dominikdeka/remote-controlled-ir-tank/shield/docs/photos/vehicle_right.jpg

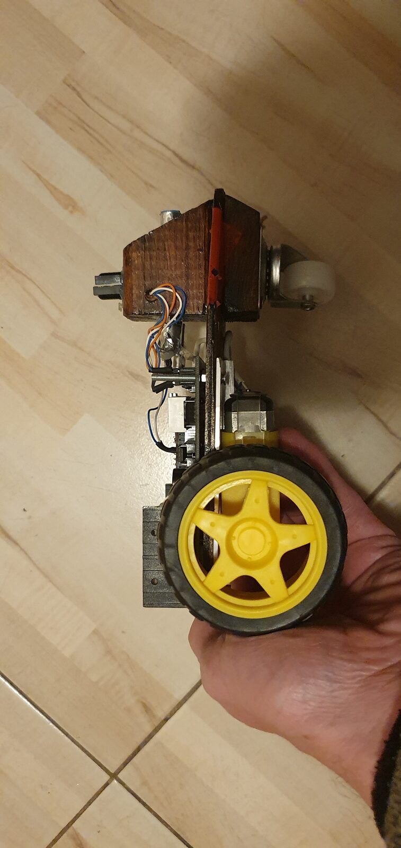
shield/docs/photos/vehicle_right.jpg
