dominikdeka/remote-controlled-ir-tank/shield/docs/photos/controller_front.jpg

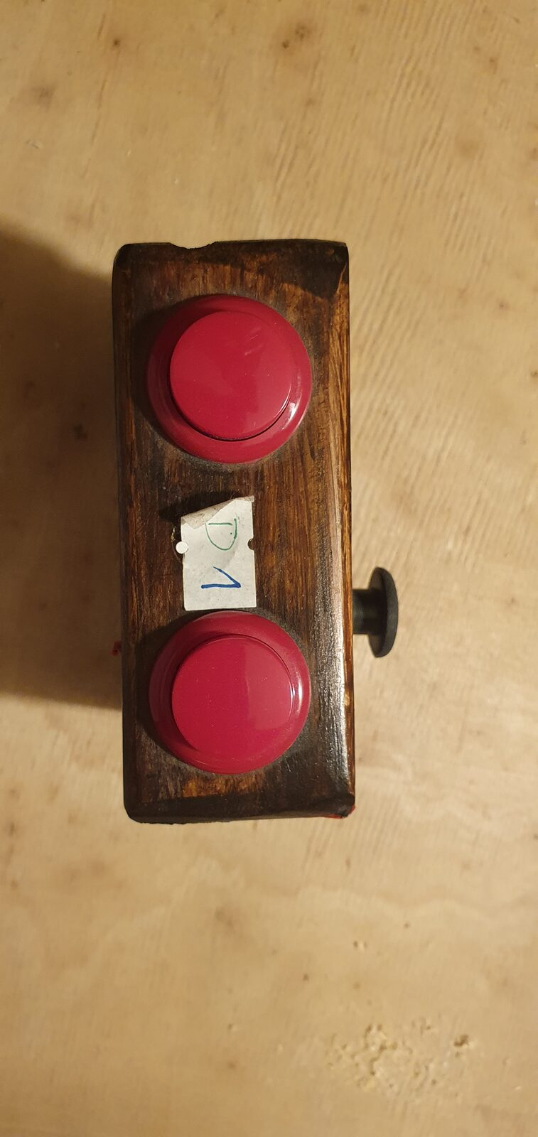
shield/docs/photos/controller_front.jpg
