dominikdeka/remote-controlled-ir-tank/README.md

# remote-controlled-ir-tank
Arduino based remote controlled vehicle with ir gun
