dominikdeka/remote-controlled-ir-tank/shield/docs/photos/controller_side.jpg

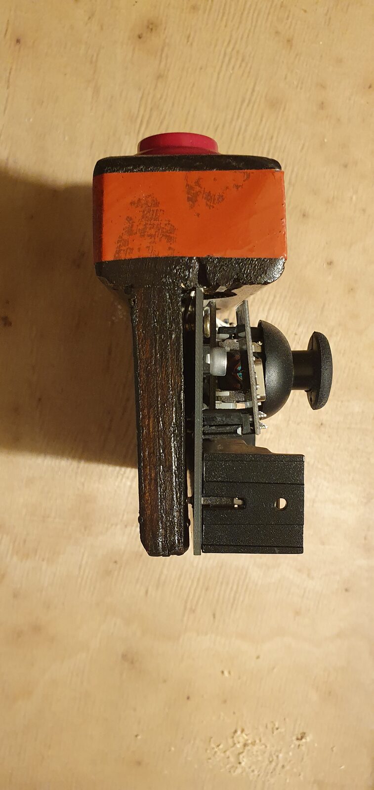
shield/docs/photos/controller_side.jpg
