dominikdeka/remote-controlled-ir-tank/shield/docs/photos/controller_top.jpg

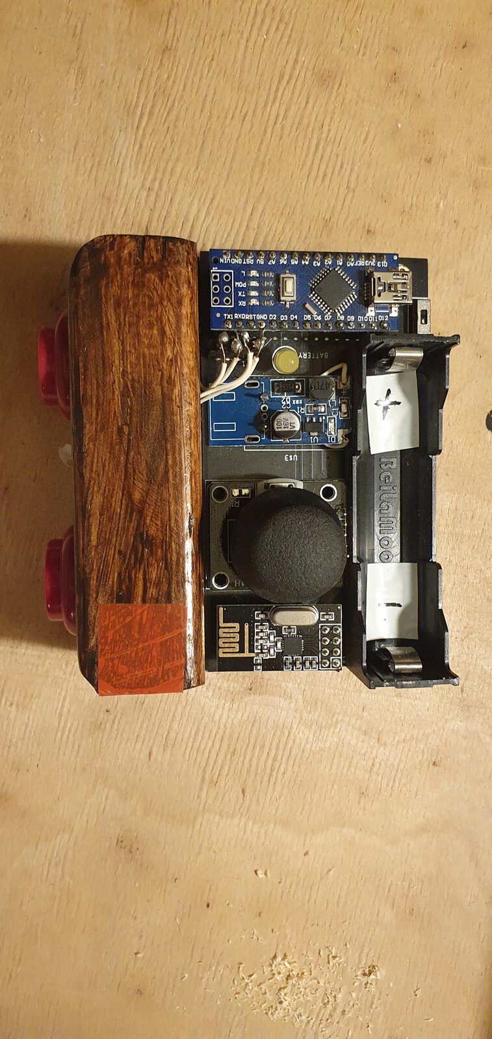
shield/docs/photos/controller_top.jpg
