dominikdeka/remote-controlled-ir-tank/shield/docs/photos/controller_top_tape.jpg

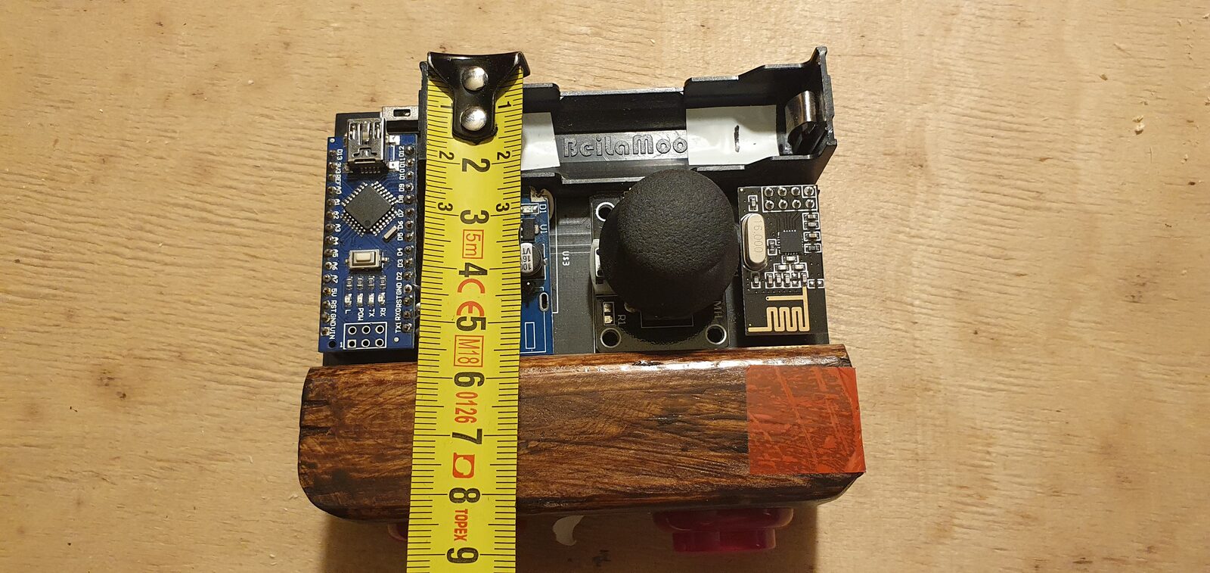
shield/docs/photos/controller_top_tape.jpg
