dominikdeka/remote-controlled-ir-tank/shield/docs/photos/prototype.jpg

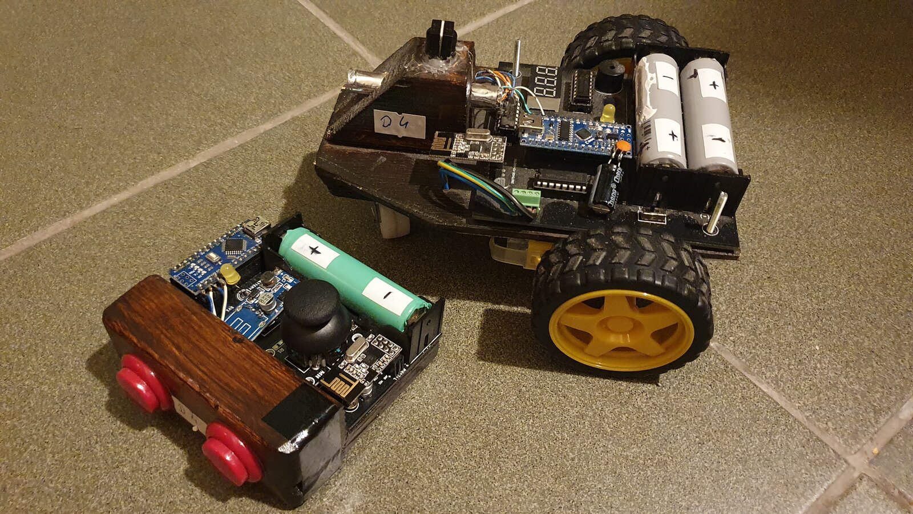
shield/docs/photos/prototype.jpg
