dominikdeka/remote-controlled-ir-tank/shield/docs/photos/tt_motor_drawing.jpg

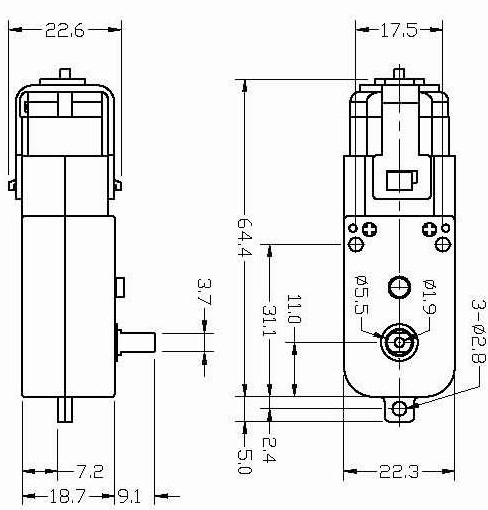
shield/docs/photos/tt_motor_drawing.jpg
