dominikdeka/remote-controlled-ir-tank/shield/docs/photos/vehicle_bottom.jpg

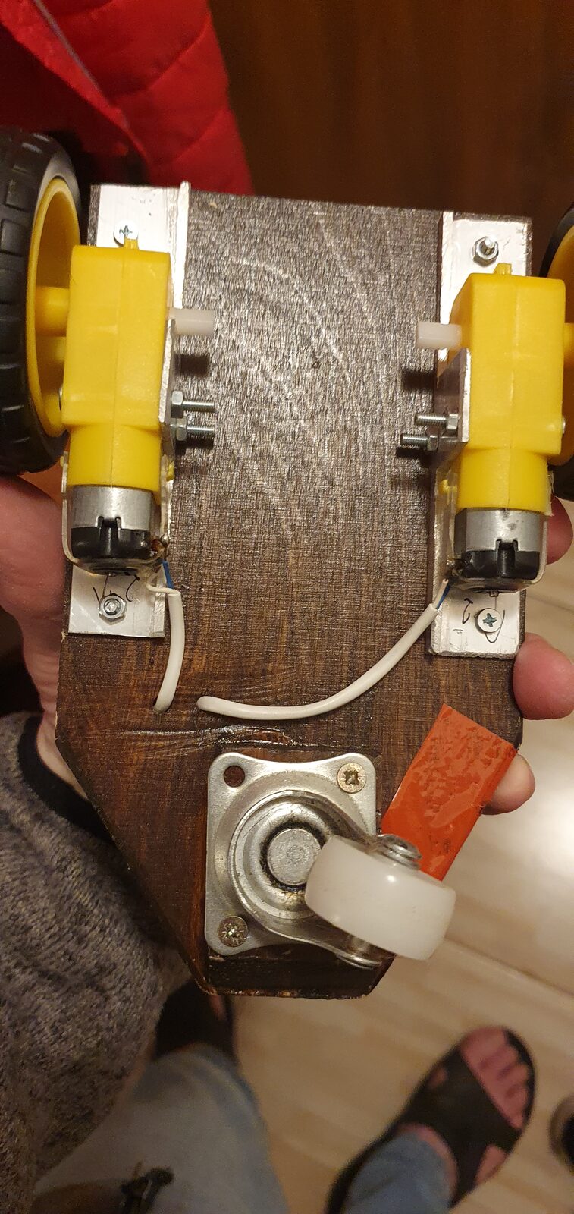
shield/docs/photos/vehicle_bottom.jpg
