dominikdeka/remote-controlled-ir-tank/shield/docs/photos/vehicle_left.jpg

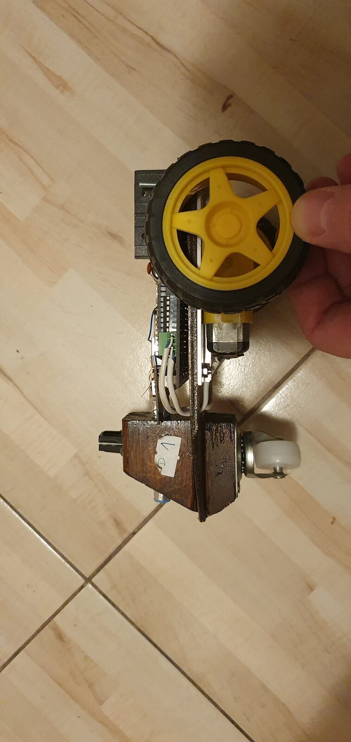
shield/docs/photos/vehicle_left.jpg
