dominikdeka/remote-controlled-ir-tank/shield/docs/photos/vehicle_motor_mount.jpg

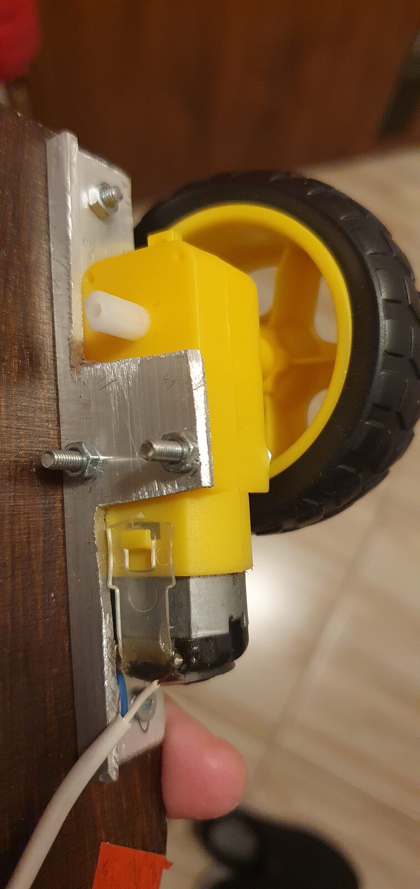
shield/docs/photos/vehicle_motor_mount.jpg
