dominikdeka/remote-controlled-ir-tank/shield/docs/photos/vehicle_rear.jpg

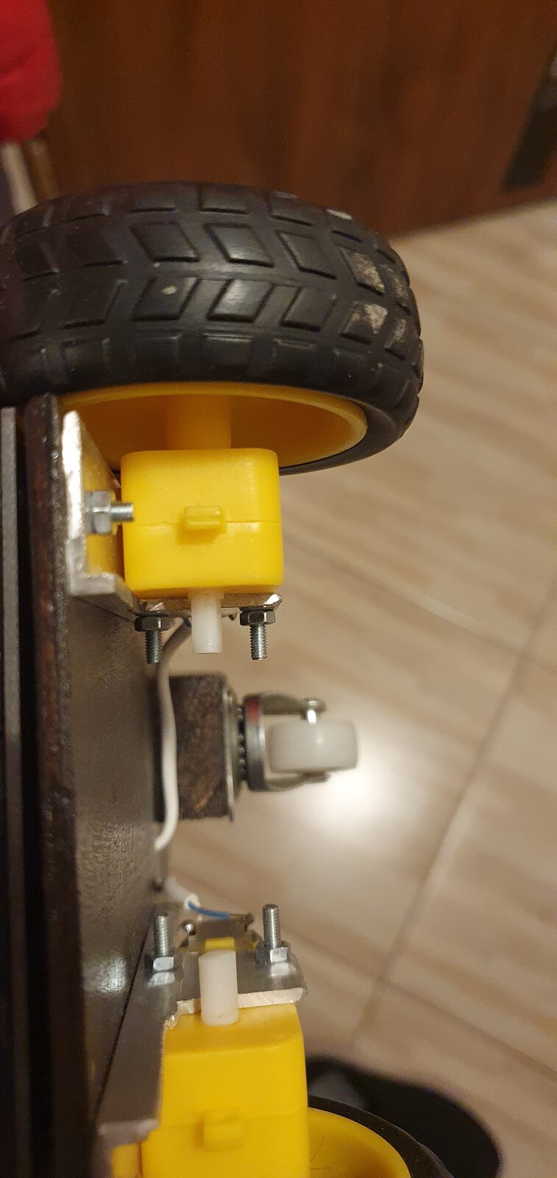
shield/docs/photos/vehicle_rear.jpg
