dominikdeka/remote-controlled-ir-tank/shield/docs/photos/vehicle_top.jpg

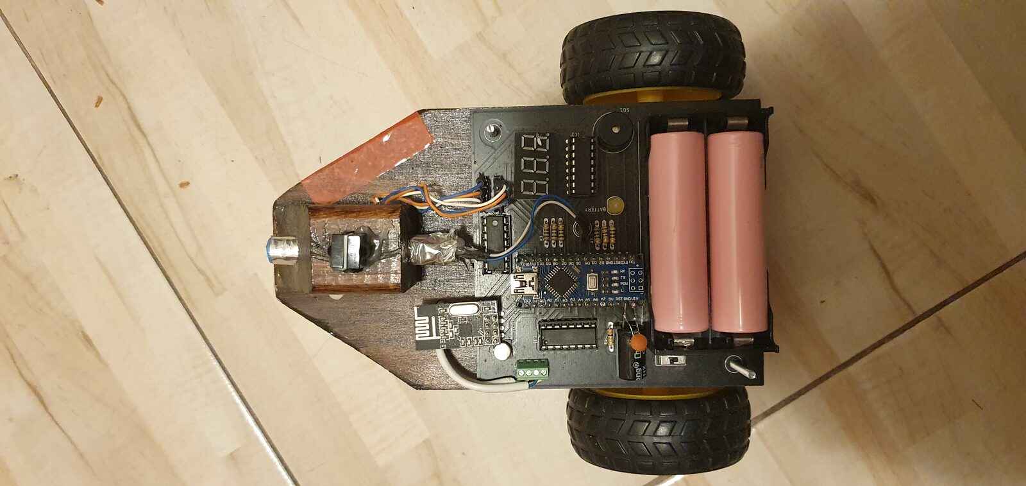
shield/docs/photos/vehicle_top.jpg
