dominikdeka/remote-controlled-ir-tank/(list of files, cad)

Other CAD files:
shield/test/m3_fit.scad
