dominikdeka/remote-controlled-ir-tank/eagle/remote_controller.brd

## EAGLE design eagle/remote_controller.brd (2020-02-14)

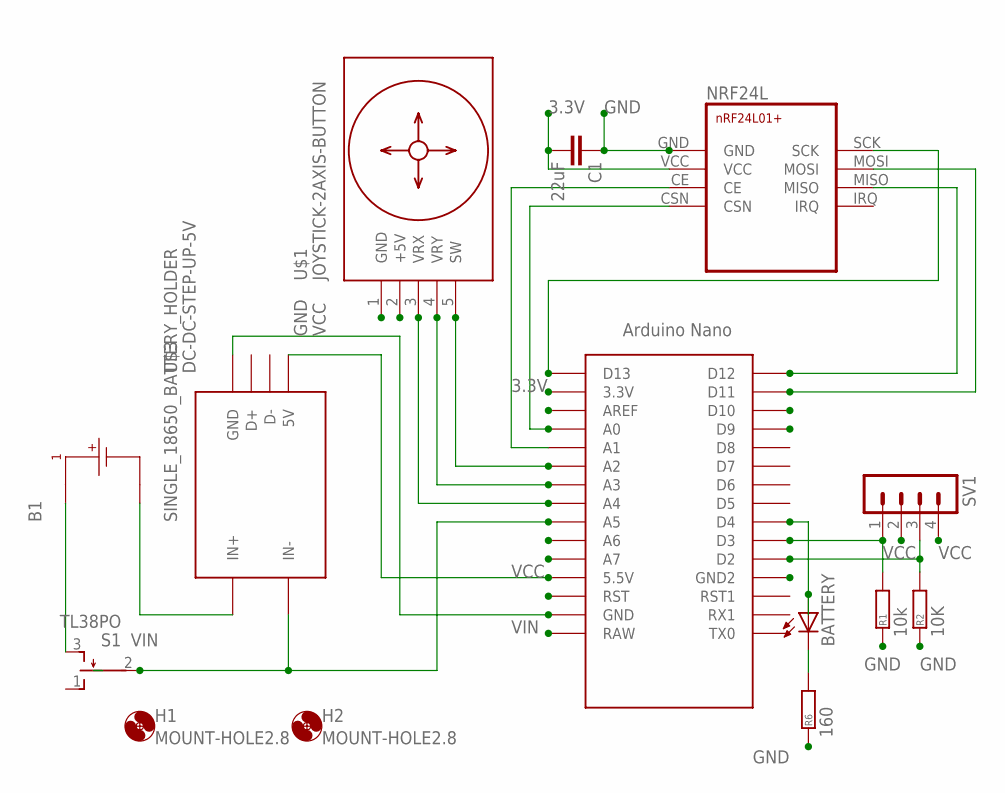
[picture p13: schematic remote_controller.sch]

Parts:
B1: SINGLE_18650_BATTERY_HOLDER; SINGLE_18650_HOLDER
BATTERY: LED5MM
C1: 22uF; C025-040X050
H1, H2: MOUNT-HOLE2.8; 2,8
NRF24L: NRF24L01+
R1: 10k; 0204/7
R2: 10K; 0204/7
R6: 160; 0204/7
S1: TL38PO; TL3XPO
SV1: MA04-1
U$1: JOYSTICK-2AXIS-BUTTON
U$2: NANO
U$3: DC-DC-STEP-UP-5V

Connections:
3.3V: C1.2, NRF24L.VCC, U$2.3.3V
A0: NRF24L.CSN, U$2.A0
A1: NRF24L.CE, U$2.A1
A2: U$1.5 (SW), U$2.A2
A3: U$1.4 (VRY), U$2.A3
A4: U$1.3 (VRX), U$2.A4
D2: R2.2, SV1.3, U$2.D2
D3: R1.2, SV1.1, U$2.D3
D4: BATTERY.A, U$2.D4
D9: U$2.D9
D10: U$2.D10
D11: NRF24L.MOSI, U$2.D11
D12: NRF24L.MISO, U$2.D12
D13: NRF24L.SCK, U$2.D13
GND: C1.1, NRF24L.GND, R1.1, R2.1, R6.1, U$1.1 (GND), U$2.GND, U$2.GND1 (GND2), U$3.GND
unnamed: B1.C1_N (1_N), U$3.IN+
unnamed: B1.C1_P (1_P), S1.3 (S)
unnamed: BATTERY.K (C), R6.2
VCC: SV1.2, SV1.4, U$1.2 (+5V), U$2.5V (5.5V), U$3.5V
VIN: S1.2, U$2.A5, U$2.RAW, U$3.IN-

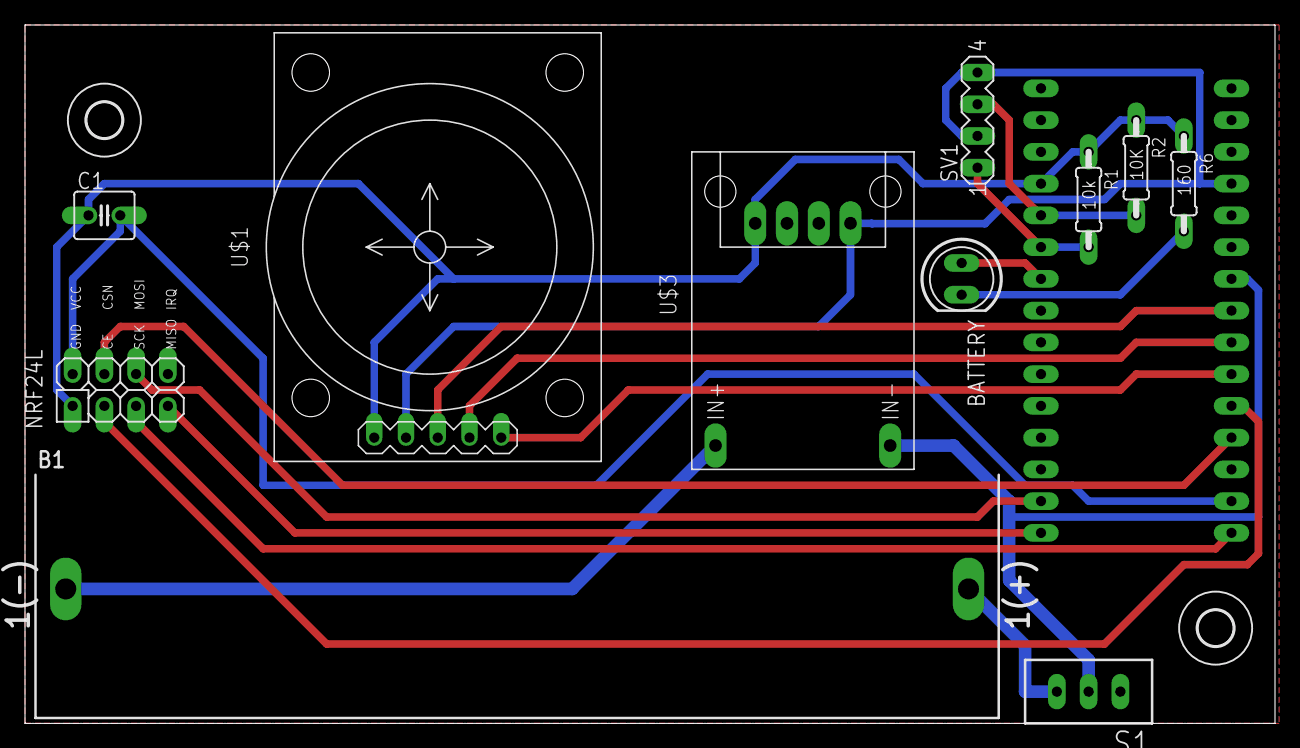
[picture p14: board remote_controller.brd from above]

Board: 2 copper layers, 100.0 x 55.9 mm, 14 parts (0 on the bottom side), 18 nets.
