dominikdeka/remote-controlled-ir-tank/eagle/ir_remote_controlled_veh.brd

## EAGLE design eagle/ir_remote_controlled_veh.brd (2020-02-14)

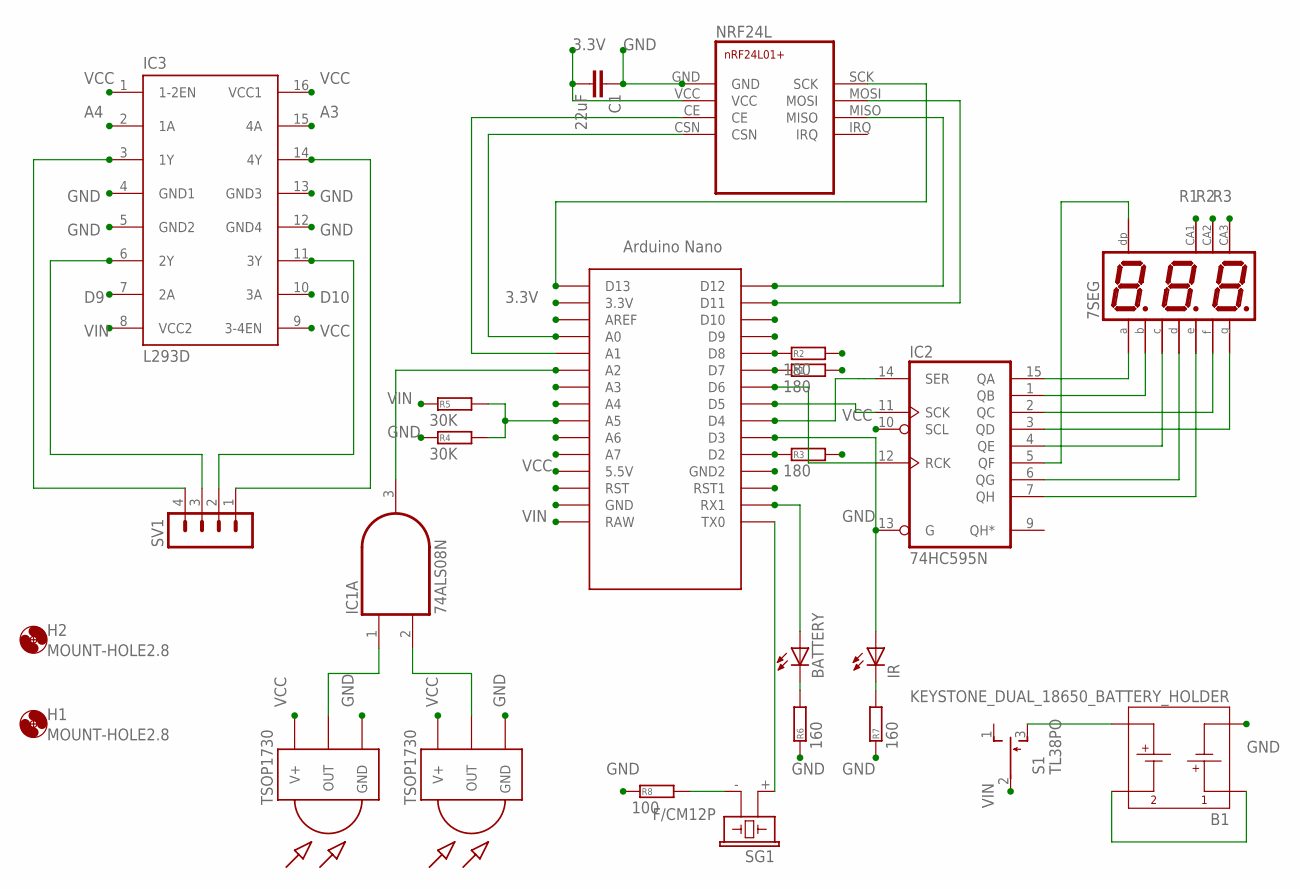
[picture p15: schematic ir_remote_controlled_veh.sch]

Parts:
7SEG: BA56-12EWA
B1: KEYSTONE_DUAL_18650_BATTERY_HOLDER; KEYSTONE_1049_DUAL_18650_HOLDER
BATTERY: LED5MM
C1: 22uF; C025-040X050
H1, H2: MOUNT-HOLE2.8; 2,8
IC1: 74ALS08N; DIL14
IC2: 74HC595N; DIL16
IC3: L293D; DIL16
IR: LED5MM
NRF24L: NRF24L01+
R1, R2, R3: 180; 0204/7
R4, R5: 30K; 0204/7
R6, R7: 160; 0204/7
R8: 100; 0204/7
S1: TL38PO; TL3XPO
SG1: F/CM12P
SV1: MA04-1
TSOP1, TSOP2: TSOP1730; TSOP17XX
U$1: NANO

Connections:
3.3V: C1.2, NRF24L.VCC, U$1.3.3V
A0: NRF24L.CSN, U$1.A0
A1: NRF24L.CE, U$1.A1
A2: IC1.3 (O), U$1.A2
A3: IC3.15 (4A), U$1.A3
A4: IC3.2 (1A), U$1.A4
A5: R4.2, R5.2, U$1.A5
D2: R3.1, U$1.D2
D3: IR.A, U$1.D3
D4: IC2.14 (SER), U$1.D4
D5: IC2.11 (SCK), U$1.D5
D6: IC2.12 (RCK), U$1.D6
D7: R1.1, U$1.D7
D8: R2.1, U$1.D8
D9: IC3.7 (2A), U$1.D9
D10: IC3.10 (3A), U$1.D10
D11: NRF24L.MOSI, U$1.D11
D12: NRF24L.MISO, U$1.D12
D13: NRF24L.SCK, U$1.D13
GND: B1.C1_N (1_N), C1.1, IC1.7 (GND), IC2.8 (GND), IC2.13 (G), IC3.4 (GND1), IC3.5 (GND2), IC3.12 (GND4), IC3.13 (GND3), NRF24L.GND, R4.1, R6.1, R7.1, R8.1, TSOP1.GND, TSOP2.GND, U$1.GND, U$1.GND1 (GND2)
unnamed: 7SEG.P$11 (A), IC2.15 (QA)
unnamed: 7SEG.P$7 (B), IC2.1 (QB)
unnamed: 7SEG.P$10 (F), IC2.2 (QC)
unnamed: 7SEG.P$5 (G), IC2.3 (QD)
unnamed: 7SEG.P$4 (C), IC2.4 (QE)
unnamed: 7SEG.P$3 (DP), IC2.5 (QF)
unnamed: 7SEG.P$2 (D), IC2.6 (QG)
unnamed: 7SEG.P$1 (E), IC2.7 (QH)
unnamed: B1.C1_P (1_P), B1.C2_N (2_N)
unnamed: B1.C2_P (2_P), S1.3 (S)
unnamed: SG1.+ (1), U$1.TX0
unnamed: BATTERY.K (C), R6.2
unnamed: IR.K (C), R7.2
unnamed: R8.2, SG1.- (2)
unnamed: IC1.1 (I0), TSOP1.OUT
unnamed: IC1.2 (I1), TSOP2.OUT
unnamed: IC3.6 (2Y), SV1.3
unnamed: IC3.3 (1Y), SV1.4
unnamed: IC3.14 (4Y), SV1.1
unnamed: IC3.11 (3Y), SV1.2
R1: 7SEG.P$8 (CA), R1.2
R2: 7SEG.P$9 (CA), R2.2
R3: 7SEG.P$12 (CA), R3.2
RX1: BATTERY.A, U$1.RX1
VCC: IC1.14 (VCC), IC2.10 (SCL), IC2.16 (VCC), IC3.1 (1-2EN), IC3.9 (3-4EN), IC3.16 (VCC1), TSOP1.V+, TSOP2.V+, U$1.5V (5.5V)
VIN: IC3.8 (VCC2), R5.1, S1.2, U$1.RAW

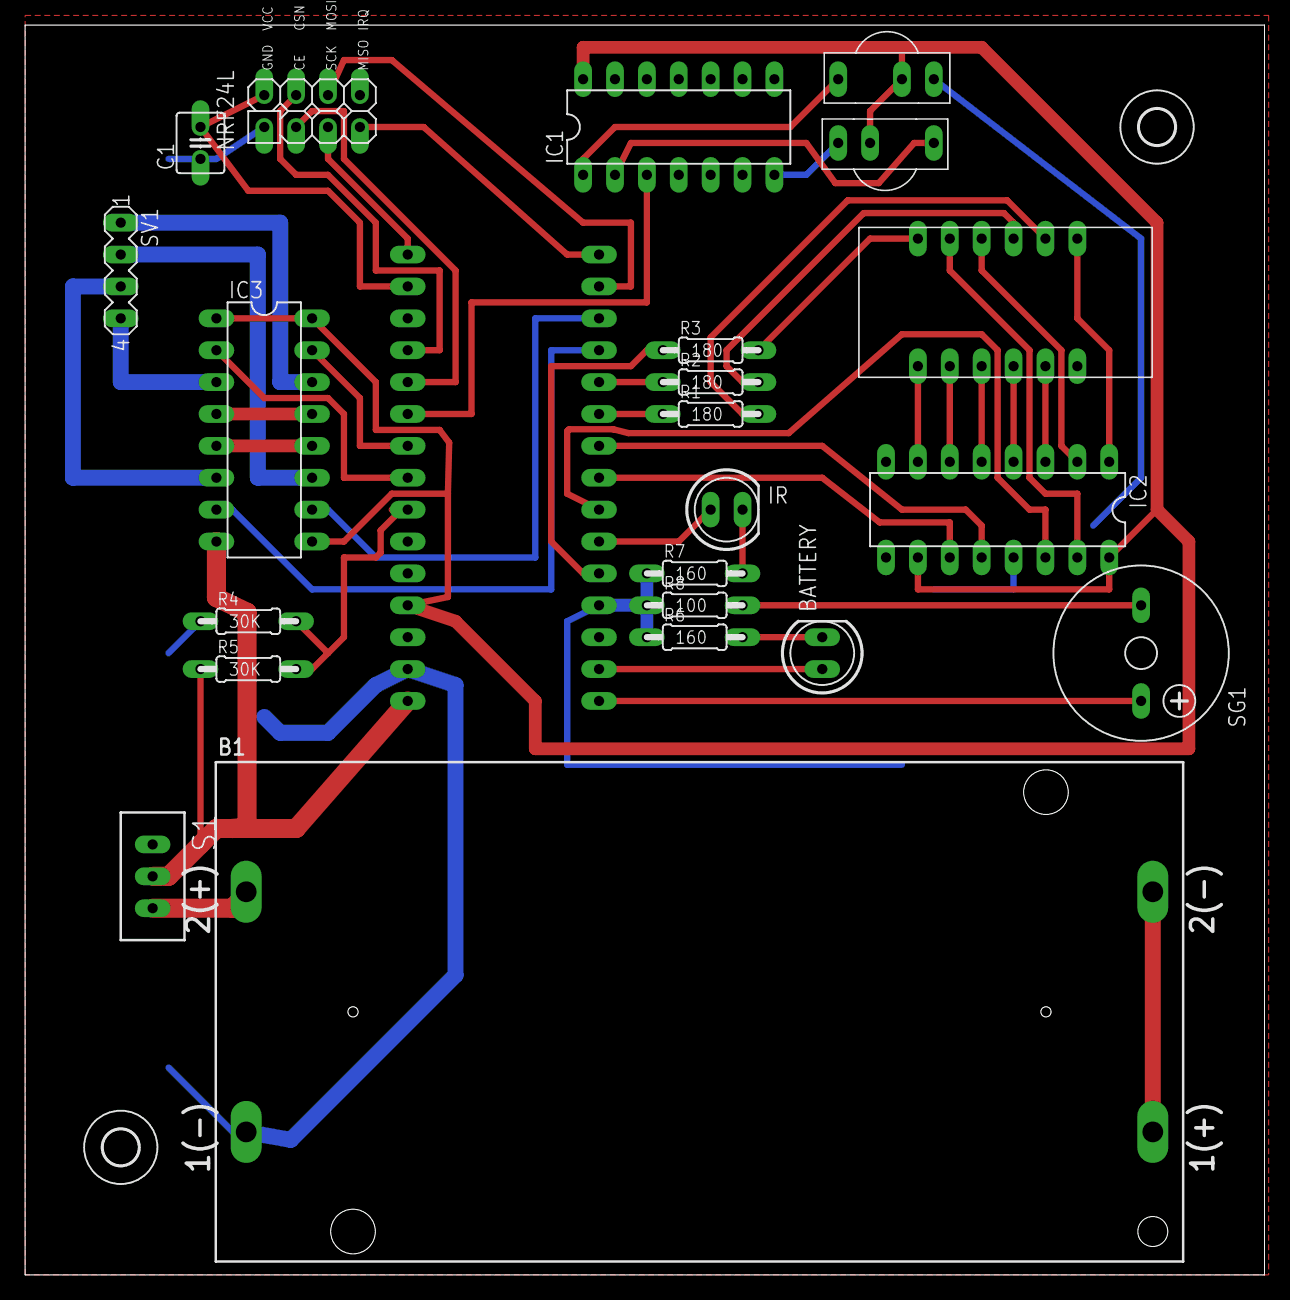
[picture p16: board ir_remote_controlled_veh.brd from above]

Board: 2 copper layers, 98.7 x 99.6 mm, 25 parts (0 on the bottom side), 46 nets.
