dominikdeka/remote-controlled-ir-tank/(commit log)

2020-02-14 eagle files added
    [ir_remote_controlled_veh.brd, ir_remote_controlled_veh.sch, remote_controller.brd, remote_controller.sch]
2026-10-26 Add 3D-printable vehicle parts and shield scaffolding
    OpenSCAD sources for the vehicle base plate, gun block, slide-in barrel,
    PCB standoffs and test coupons, with board data extracted from the .brd
    files and a Makefile that builds STL files into shield/build/.
    Claude-Session: https://claude.ai/code/session_01FG3yuyBnriZibok9pDoeqm
2026-10-26 Add printable controller case
    One-piece case with the button block, printed on the block front face.
    Closed hollow underside and rounded outer edges for handheld use.
    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
2026-11-02 Rework vehicle nose, switch to M3 screws, add caster pilot holes
    - Gun block and caster spacer end at the plate front edge as a nose, both 40 wide
    (measured caster plate 40 x 34). The barrel sticks out in front of the plate.
    - Barrel test set 50/60/70.
    - Motors moved back; the motor walls end at the plate rear edge.
    - Screws are M3, not M2.5. Clearances from test/m3_fit (hole 0.3, nut 0.4).
    - Caster held by self-tapping screws in 2 mm pilot holes, 10 deep, with a ring
    slit for solid walls. New test/caster_holes coupon.
    - Extra vehicle preview angles (side, front, top).
    Claude-Session: https://claude.ai/code/session_01FG3yuyBnriZibo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
